amichayfrid-cell/Hall-control-mixer/MixerController/README.md

מיקסר מבוסס על ESP32 עבור מערכת הגברה לאולם שלי.
