amichayfrid-cell/Hall-control-mixer/PCB/V2/SCH_Schematic1_1-P1_2026-01-28.png

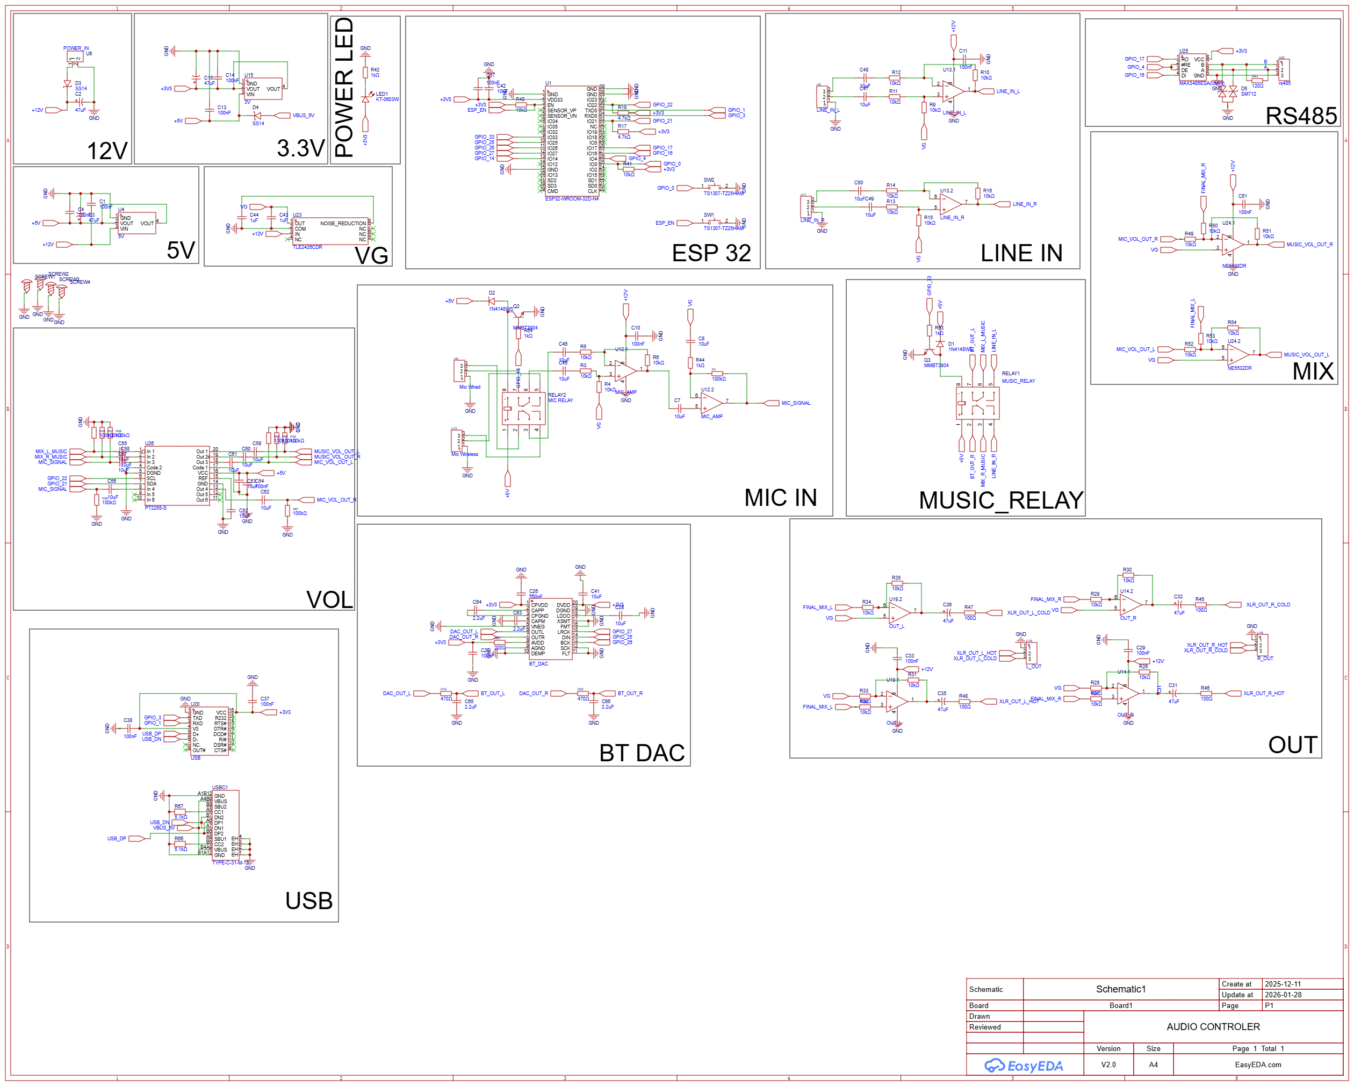
PCB/V2/SCH_Schematic1_1-P1_2026-01-28.png
