amichayfrid-cell/Hall-control-mixer/PCB/V2/BOM_Board1_PCB4_2026-01-28.xlsx

No. | Quantity | Comment | Designator | Footprint | Value | Manufacturer Part | Manufacturer | Supplier Part | Supplier
1 | 14 | 100nF | C1,C4,C10,C11,C13,C14,C26,C27,C29,C33,C37,C38,C51,C54 | C0805 | 100nF | CC0805KRX7R9BB104 | YAGEO(国巨) | C49678 | LCSC
2 | 7 | 47uF | C2,C3,C15,C31,C32,C35,C36 | CAP-SMD_BD6.3-L6.6-W6.6-LS7.6-FD | 47uF | RVT1H470M0607 | ROQANG(容强) | C72523 | LCSC
3 | 11 | 10uF | C7,C8,C28,C41,C42,C45,C46,C47,C48,C49,C50 | C0805 | 10uF | CL21A106KAYNNNE | SAMSUNG(三星) | C15850 | LCSC
4 | 2 | 1uF | C43,C44 | C0603 | 1uF | CGA0603X5R105K500JT | HRE(芯声) | C6119852 | LCSC
5 | 10 | 10uF | C52,C53,C55,C56,C57,C58,C59,C60,C61,C62 | C0603 | 10uF | GRM188R60J106KE47D | muRata(村田) | C77040 | LCSC
6 | 4 | 2.2uF | C63,C64,C65,C66 | C0603 | 2.2uF | CL10A225KO8NNNC | SAMSUNG(三星) | C23630 | LCSC
7 | 1 | 100nF | C67 | C0402 | 100nF | CT41G-0402-2X1-16V-0.1uF-K(N) | TORCH(火炬) | C141382 | LCSC
8 | 2 | 1N4148WS | D1,D2 | SOD-323_L1.8-W1.3-LS2.5-RD |  | 1N4148WS | SHIKUES(时科) | C110221 | LCSC
9 | 2 | SS14 | D3,D4 | SMA_L4.2-W2.6-LS5.0-RD_1 |  | SS14 | MDD(辰达半导体) | C2480 | LCSC
10 | 1 | SM712 | D5 | SOT-23-3_L2.9-W1.3-P1.90-LS2.4-BR |  | SM712 | FUXINSEMI(富芯森美) | C908219 | LCSC
11 | 1 | KT-0603W | LED1 | LED0603-R-RD_WHITE |  | KT-0603W | KENTO | C2290 | LCSC
12 | 2 | MMBT3904 | Q2,Q3 | SOT-23-3_L3.0-W1.7-P0.95-LS2.9-BR |  | MMBT3904 | Nexperia(安世) | C108429 | LCSC
13 | 30 | 10kΩ | R3,R4,R5,R6,R9,R10,R11,R12,R13,R14,R15,R16,R26,R27,R28,R29,R30,R31,R32,R33,R34,R35,R40,R41,R49,R50,R51,R52,R53,R54 | R0805 | 10kΩ | 0805W8F1002T5E | UNI-ROYAL(厚声) | C17414 | LCSC
14 | 9 | 100kΩ | R7,R55,R56,R57,R58,R59,R60,R61,R62 | R0805 | 100kΩ | 0805W8F1003T5E | UNI-ROYAL(厚声) | C149504 | LCSC
15 | 2 | 4.7kΩ | R17,R18 | R0805 | 4.7kΩ | 0805W8F4701T5E | UNI-ROYAL(厚声) | C17673 | LCSC
16 | 2 | 470Ω | R19,R20 | R0805 | 470Ω | 0805W8F4700T5E | UNI-ROYAL(厚声) | C17710 | LCSC
17 | 4 | 1kΩ | R42,R44,R63,R64 | R0805 | 1kΩ | 0805W8F1001T5E | UNI-ROYAL(厚声) | C17513 | LCSC
18 | 1 | 120Ω | R43 | R0603 | 120Ω | 0603WAF1200T5E | UNI-ROYAL(厚声) | C22787 | LCSC
19 | 4 | 100Ω | R45,R46,R47,R48 | R0603 | 100Ω | 0603WAF1000T5E | UNI-ROYAL(厚声) | C22775 | LCSC
20 | 1 | 220Ω | R65 | R0603 | 220Ω | 0603WAF2200T5E | UNI-ROYAL(厚声) | C22962 | LCSC
21 | 2 | 5.1kΩ | R66,R67 | R0603 | 5.1kΩ | HoARG0603-1/10W-5.1KR-0.1%-TCR25 | Milliohm(毫欧) | C5123614 | LCSC
22 | 1 | MUSIC_RELAY | RELAY1 | RELAY-SMD_HFD4-5-SR |  | MUSIC_RELAY | HF(宏发) | C64399 | LCSC
23 | 1 | MIC RELAY | RELAY2 | RELAY-SMD_HFD4-5-SR |  | MIC RELAY | HF(宏发) | C64399 | LCSC
24 | 4 | Screw-Hole-M3 | SCREW1,SCREW2,SCREW3,SCREW4 | Screw-Hole-M3
25 | 2 | TS1307-TZ25HAM | SW1,SW2 | SW-SMD_L6.0-W3.5-LS8.0-1 |  | TS1307-TZ25HAM | BXCONN(宝讯) | C36938869 | LCSC
26 | 1 | ESP32-WROOM-32D-N4 | U1 | WIFIM-SMD_39P-L25.5-W18.0-P1.27-BL |  | ESP32-WROOM-32D-N4 | ESPRESSIF(乐鑫) | C473012 | LCSC
27 | 1 | BT_DAC | U3 | TSSOP-20_L6.5-W4.4-P0.65-LS6.4-BL |  | BT_DAC | TI(德州仪器) | C107671 | LCSC
28 | 1 | 5V | U4 | SOT-223_L6.5-W3.5-P2.30-LS7.0-BR |  | 5V | AMS | C6187 | LCSC
29 | 1 | POWER_IN | U6 | CONN-TH_2P-P5.08_DB128L-5.08-2P |  | POWER_IN | DORABO(地博电气) | C395868 | LCSC
30 | 1 | Mic Wired | U8 | CONN-TH_3P-P5.08_KF129-5.08-3P |  | Mic Wired | KEFA(科发) | C475093 | LCSC
31 | 1 | LINEֹֹ_IN_L | U9 | CONN-TH_3P-P5.08_KF129-5.08-3P |  | LINEֹֹ_IN_L | KEFA(科发) | C475093 | LCSC
32 | 1 | Mic Wireless | U10 | CONN-TH_3P-P5.08_KF129-5.08-3P |  | Mic Wireless | KEFA(科发) | C475093 | LCSC
33 | 1 | LINE_IN_R | U11 | CONN-TH_3P-P5.08_KF129-5.08-3P |  | LINE_IN_R | KEFA(科发) | C475093 | LCSC
34 | 1 | MIC_AMP | U12 | SOIC-8_L4.9-W3.9-P1.27-LS6.0-BL |  | MIC_AMP | TI(德州仪器) | C7426 | LCSC
35 | 1 | LINEֹֹ_IN_L | U13 | SOIC-8_L4.9-W3.9-P1.27-LS6.0-BL |  | LINEֹֹ_IN_L | TI(德州仪器) | C7426 | LCSC
36 | 1 | OUT_R | U14 | SOIC-8_L4.9-W3.9-P1.27-LS6.0-BL |  | OUT_R | TI(德州仪器) | C7426 | LCSC
37 | 1 | 3V | U15 | SOT-223-3_L6.5-W3.4-P2.30-LS7.0-BR |  | 3V | AMS | C6186 | LCSC
38 | 1 | R_OUT | U16 | CONN-TH_3P-P5.08_KF129-5.08-3P |  | R_OUT | KEFA(科发) | C475093 | LCSC
39 | 1 | L_OUT | U18 | CONN-TH_3P-P5.08_KF129-5.08-3P |  | L_OUT | KEFA(科发) | C475093 | LCSC
40 | 1 | OUT_L | U19 | SOIC-8_L4.9-W3.9-P1.27-LS6.0-BL |  | OUT_L | TI(德州仪器) | C7426 | LCSC
41 | 1 | USB | U20 | SOP-16_L10.0-W3.9-P1.27-LS6.0-BL |  | USB | WCH(南京沁恒) | C84681 | LCSC
42 | 1 | rs485 | U22 | CONN-TH_3P-P5.08_KF129-5.08-3P |  | rs485 | KEFA(科发) | C475093 | LCSC
43 | 1 | TLE2426CDR | U23 | SOIC-8_L4.9-W3.9-P1.27-LS6.0-BL |  | TLE2426CDR | TI(德州仪器) | C2156577 | LCSC
44 | 1 | NE5532DR | U24 | SOIC-8_L4.9-W3.9-P1.27-LS6.0-BL |  | NE5532DR | TI(德州仪器) | C7426 | LCSC
45 | 1 | MAX3485ESA(UMW) | U25 | SOP-8_L5.0-W4.0-P1.27-LS6.0-BL |  | MAX3485ESA(UMW) | UMW(友台半导体) | C668204 | LCSC
46 | 1 | PT2258-S | U26 | SOP-20_L12.8-W7.5-P1.27-LS10.4-BL |  | PT2258-S | PTC(普诚) | C99213 | LCSC
47 | 1 | TYPE-C-31-M-12 | USBC1 | USB-C_SMD-TYPE-C-31-M-12_1 |  | TYPE-C-31-M-12 | 韩国韩荣 | C165948 | LCSC
