amichayfrid-cell/Hall-control-mixer/PCB/V2/SCH_Schematic1_2026-01-28.pdf

# +12VGND

## GND+3V³

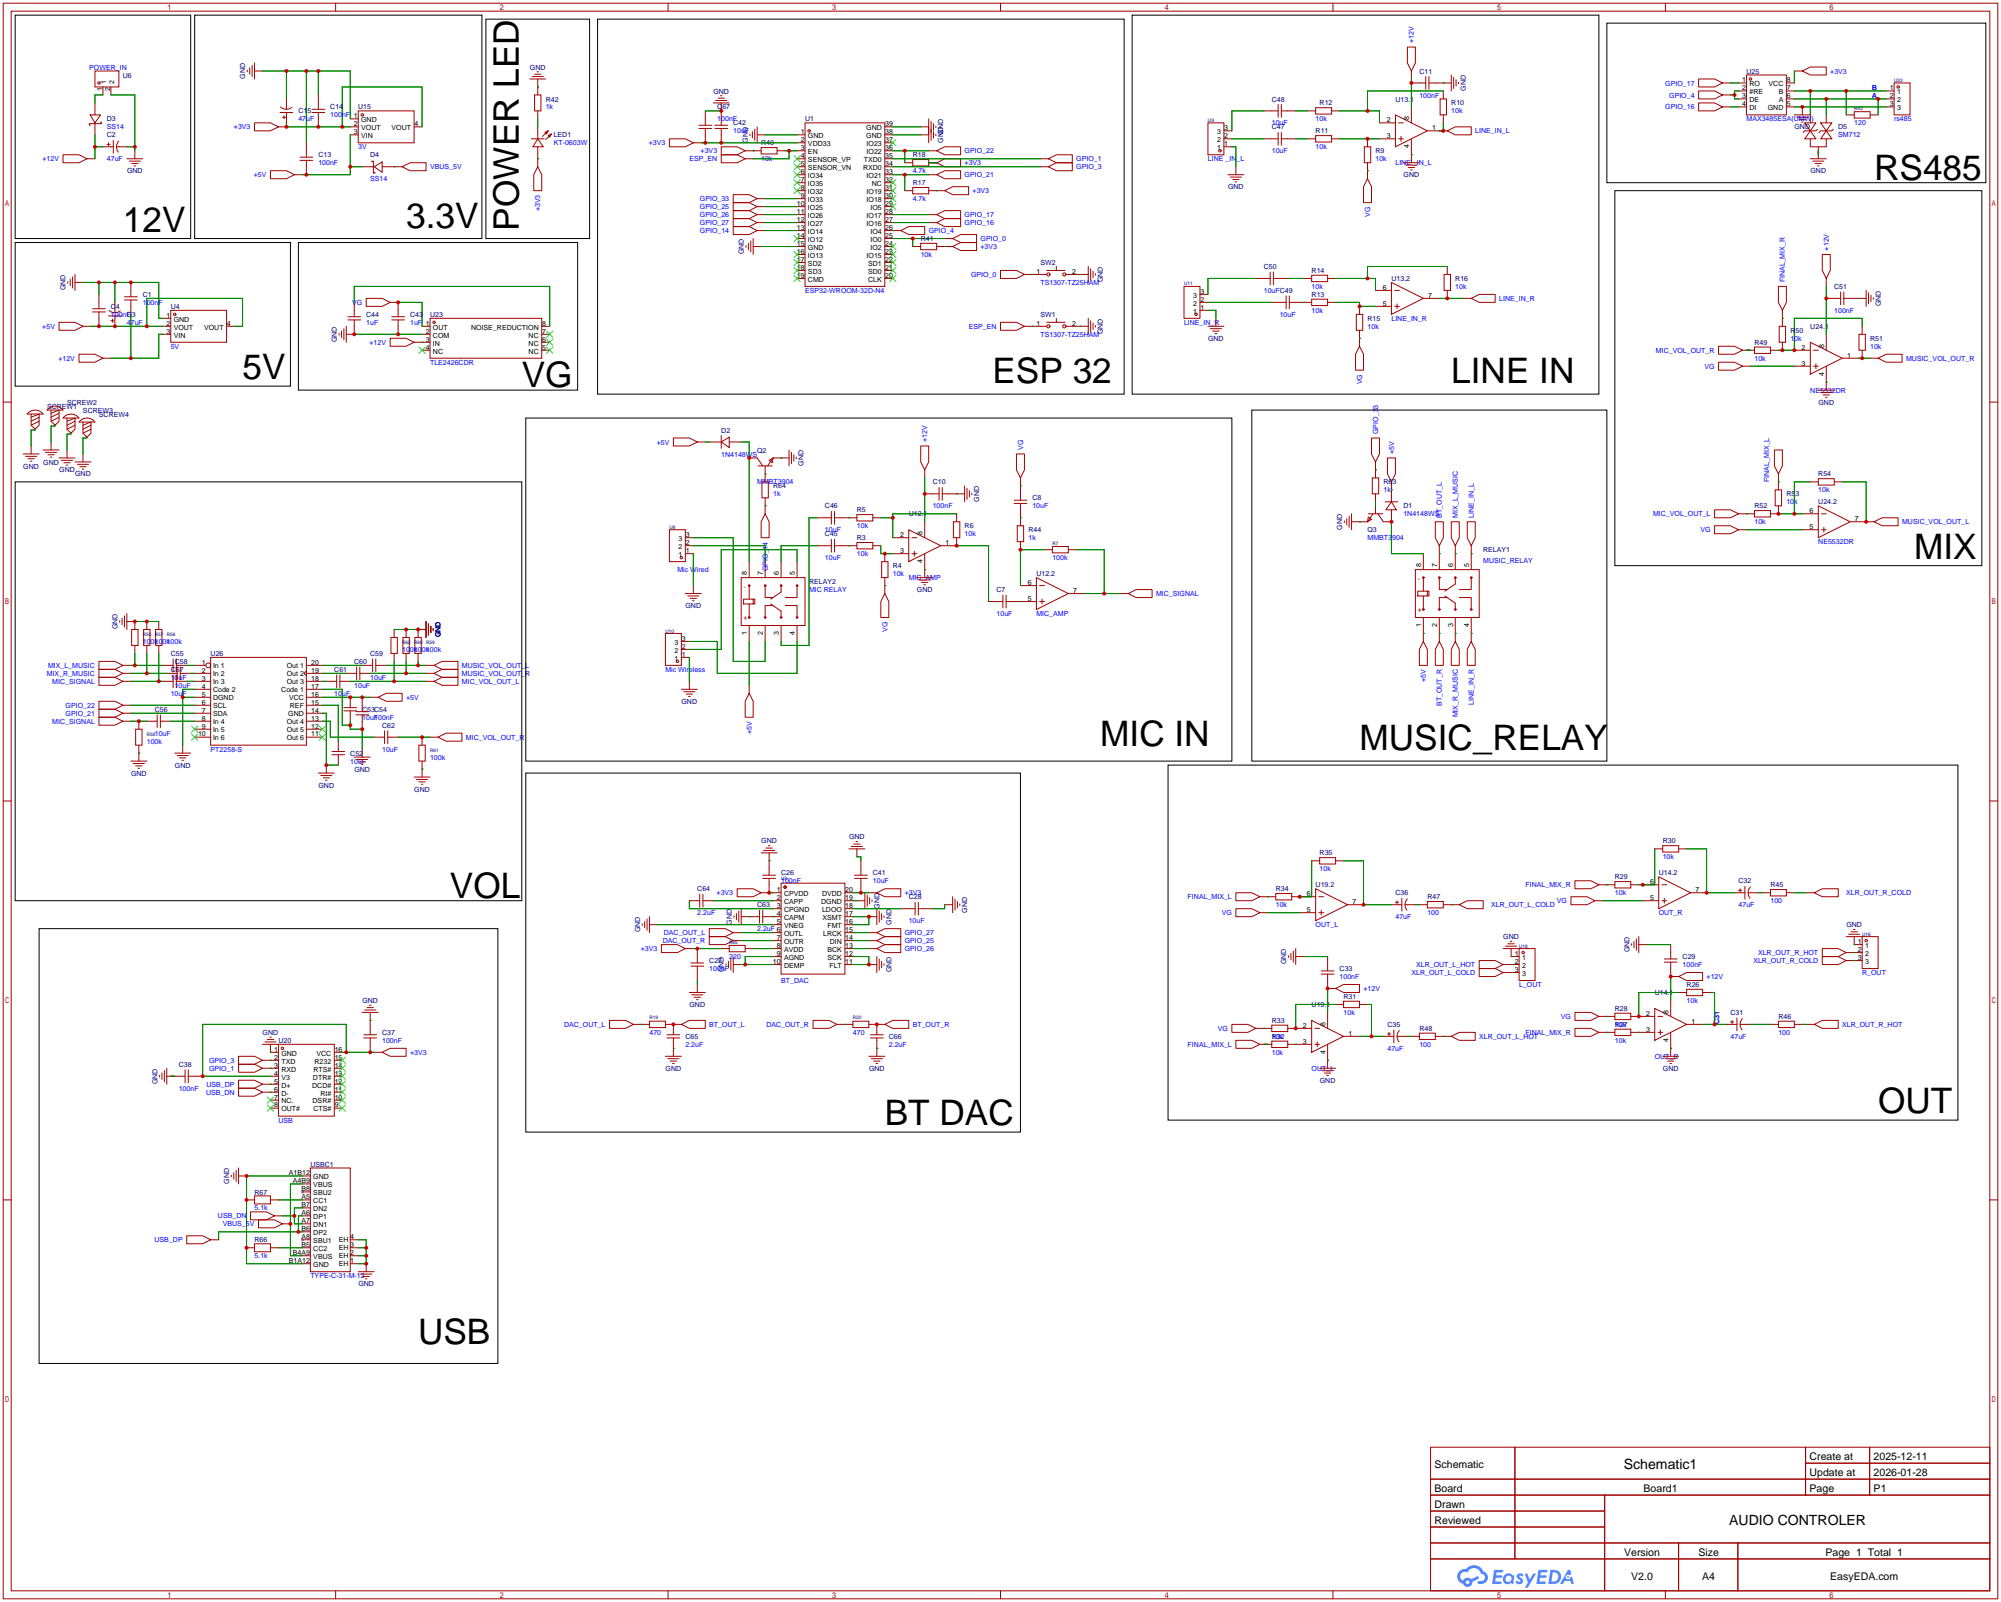
[picture p39: page 1]

DSR# 10 RI# 11 DCD# 12 DTR# 13 RTS# 14 R232 15 VCC 16

Schematic | Schematic1 | Create at | 2025-12-11

Update at | 2026-01-28

Board | Board1 | Page | P1
Drawn | | AUDIO CONTROLER
Reviewed

Version | Size | Page 1 Total 1
V2.0 | A4 | EasyEDA.com
