amichayfrid-cell/Hall-control-mixer/(list of files, drawings)

Other design files:
PCB/V1/ProPrj_AUDIO CONTROLER_2026-01-01.epro
