amichayfrid-cell/Hall-control-mixer/(commit log)

2026-01-12 Initial commit of the entire project
    [BOM_Board1_PCB4_2026-01-01.xlsx, PickAndPlace_PCB4_2026-01-01.xlsx, ProPrj_AUDIO CONTROLER_2026-01-01.epro, code-format.cfg]
2026-01-13 Fix project structure and add fader reset
    [app_data.cpp, app_data.h, main.cpp]
2026-01-18 Adjust power on/off hierarchy sequence
2026-01-28 PCB version 2
    [BOM_Board1_PCB4_2026-01-01.xlsx, BOM_Board1_PCB4_2026-01-28.xlsx, PickAndPlace_PCB4_2026-01-01.xlsx, PickAndPlace_PCB4_2026-01-28.xlsx, ProPrj_AUDIO CONTROLER_2026-01-01.epro]
2026-02-10 Fix display stability: Manufacturer BSP port, 18MHz PCLK, Multicore Offload
    [app_data.cpp, main.cpp]
2026-02-14 fix: switch to ESP32_Display_Panel for stable 23-30 FPS display
    - Replace LovyanGFX with official Waveshare ESP32_Display_Panel library
    - Add esp_panel_board_custom_conf.h (800x480, CH422G, GT911, bounce buffer)
    - Rewrite bsp.cpp: Board object, anti-tearing mode 3, VSync sync, LVGL FreeRTOS task
    - Restore main.cpp from production backup with LVGL mutex protection
    - Rewrite lv_conf.h: full LVGL 8.4 config with BIDI for Hebrew
    - Optimize: throttled NVS saves (max 1/10s), PCLK 14MHz, bounce buf x20
    - Fix delay(50) -> vTaskDelay in UI event handlers
    [app_data.cpp, app_data.h, esp_panel_board_custom_conf.h, main.cpp, ui_events_impl.cpp]
2026-02-14 feat: add power sensing toggle with 15s shutdown delay MixerController: - Add power_sensing_enabled toggle on Screen 2 (technician screen) - 15-second countdown before shutdown (allows disabling in t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
    [app_data.cpp, app_data.h, main.cpp, ui_events_impl.cpp]
